laberge1/ZED-F9P_FeatherWing_USB/Eagle/PCB/ZED-F9P GNSS FeatherWing/ZED-F9P GNSS FeatherWing.kicad_pcb

## KiCad design Eagle/PCB/ZED-F9P GNSS FeatherWing/ZED-F9P GNSS FeatherWing.kicad_pcb (2026-06-07)

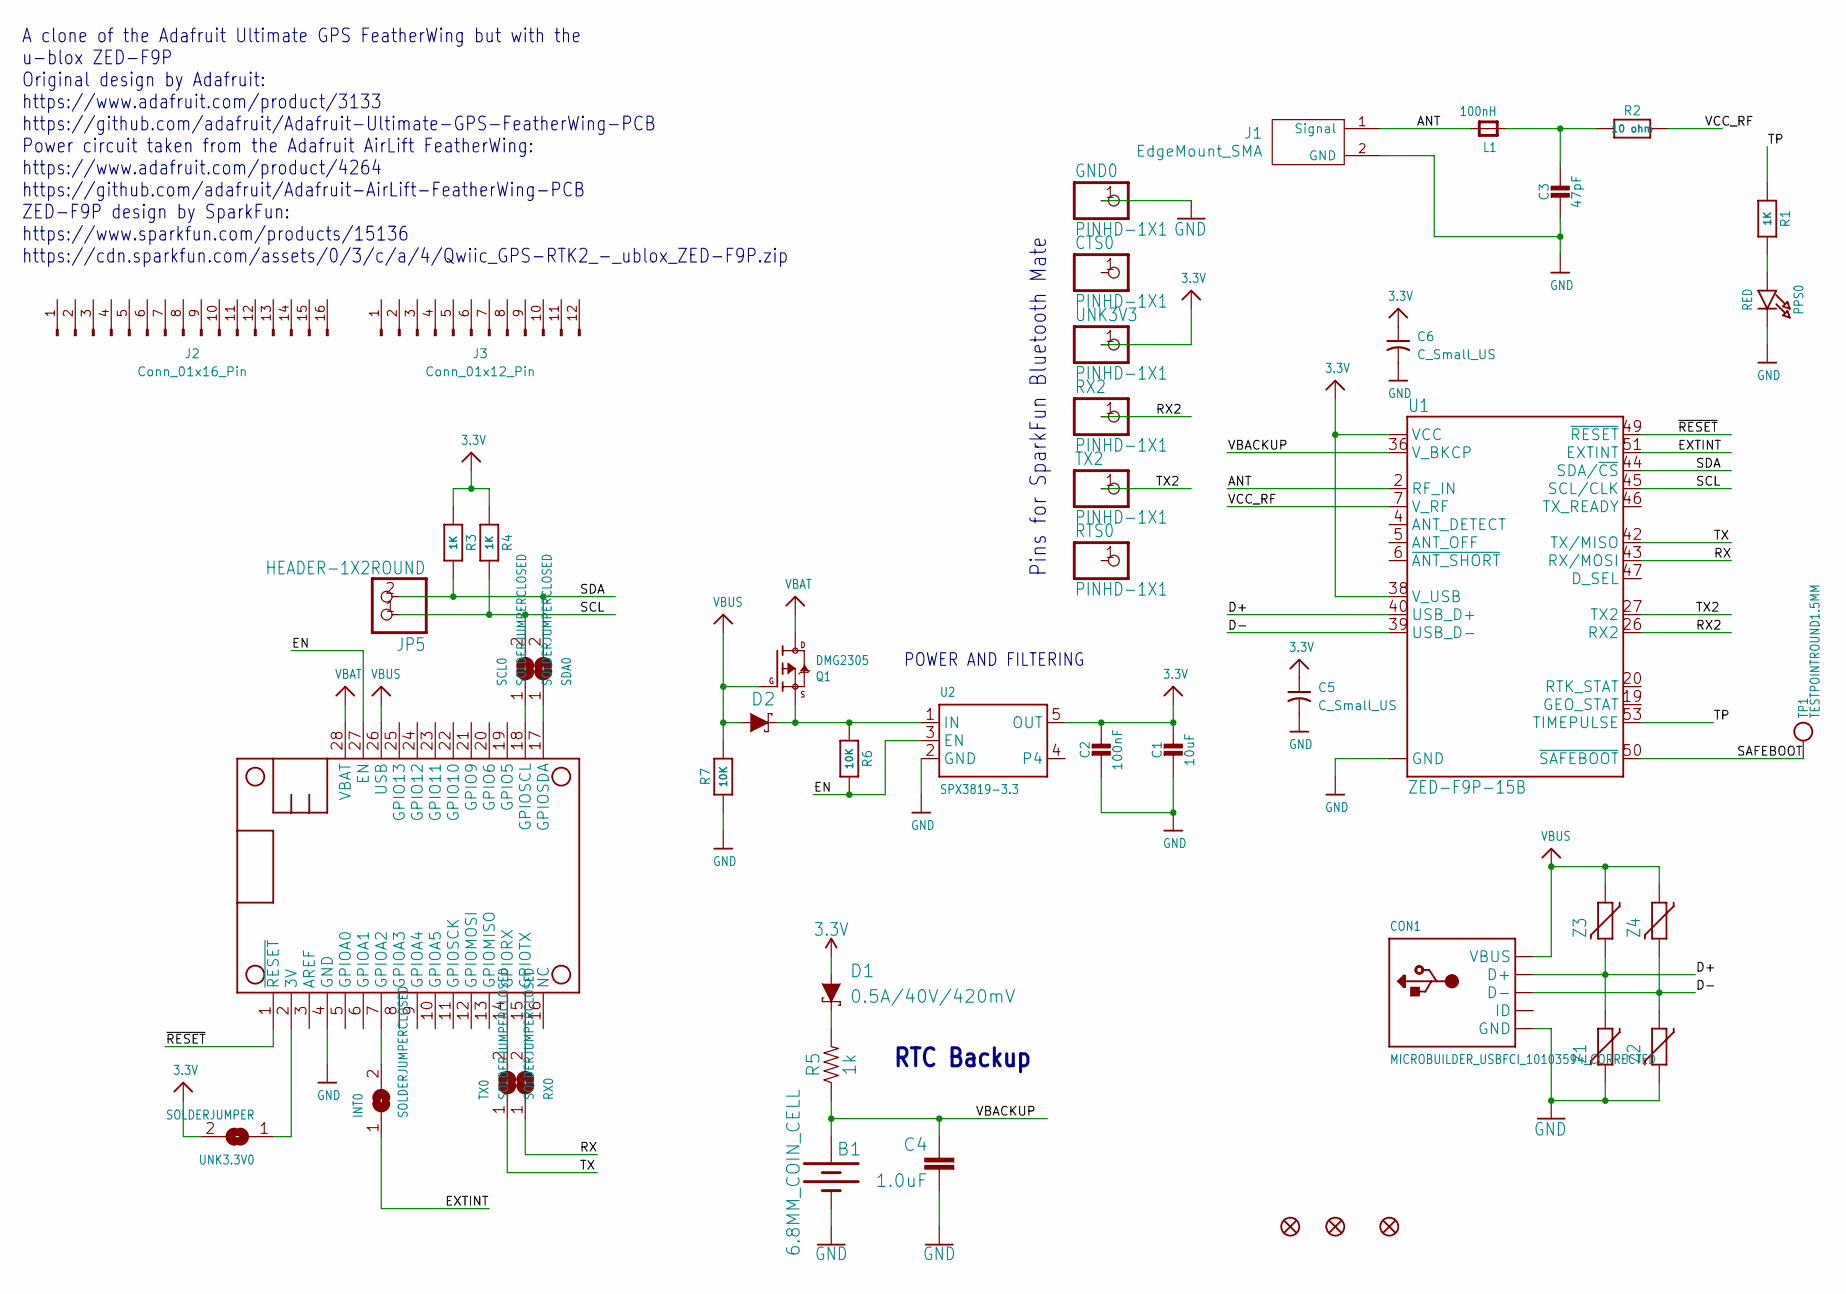
[picture p1: schematic ZED-F9P GNSS FeatherWing.kicad_sch]

Parts:
B1: 6.8MM_COIN_CELL; BATTCON-6.8MM; Digikey PN 728-1057-ND
C1: 10uF; 0805-NO; Voltage 6.3V; Digikey PN 1276-1298-1-ND
C2: 100nF; 0805-NO; Voltage 25V; Digikey PN 1276-2442-1-ND
C3: 47pF; C_0402_1005Metric; Digikey PN 490-14446-1-ND
C4: 1.0uF; 0603; Voltage 10V; Digikey PN 1276-1945-1-ND
C5, C6: C_Small_US; C_0402_1005Metric; Digikey PN 1276-1043-1-ND
CON1: MICROBUILDER_USBFCI_10103594_CORRECTED; MICROBUILDER_FCI_10103594_CORRECTED; Digikey PN 609-4050-1-ND
CTS0: PINHD-1X1; 1X01
D1, D2: 0.5A/40V/420mV; SOD-323; Digikey PN 1801-BAT201M3RRGCT-ND
FID1, FID2, FID3: FIDUCIAL""; Fiducial_0.5mm_Mask1mm
GND0: PINHD-1X1; 1X01
INT0: SOLDERJUMPERCLOSED; SolderJumper-2_P1.3mm_Bridged_RoundedPad1.0x1.5mm
J1: EdgeMount_SMA; SMA_Molex_0732512120; Digikey PN WM5536-ND
J2: Conn_01x16_Pin; Digikey PN 2223-SSK01-MPH-254-A16-ND
J3: Conn_01x12_Pin; Digikey PN 2223-SSK01-MPH-254-A12-ND
JP5: HEADER-1X2ROUND; 1X02_ROUND
L1: 100nH; L_0603_1608Metric; Digikey PN 490-15766-1-ND
MS1: MICROBUILDER_FEATHERWINGMICROBUILDER_FEATHERWING_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; MICROBUILDER_FEATHERWING_HOLES
PPS0: RED; CHIPLED_0805_NOOUTLINE; Digikey PN 732-4984-1-ND
Q1: DMG2305; SOT23-R; Digikey PN FDN340PCT-ND
R1, R3, R4: 1K; 0603-NO; Digikey PN 13-RT0603FRE131KLCT-ND
R2: 10 ohm; R_0402_1005Metric; Digikey PN CR0402-JW-100GLFCT-ND
R5: 1k; 0603; Digikey PN 13-RT0603FRE131KLCT-ND
R6, R7: 10K; 0603-NO; Digikey PN RNCP0603FTD10K0CT-ND
RTS0: PINHD-1X1; 1X01
RX0: SOLDERJUMPERCLOSED; SolderJumper-2_P1.3mm_Bridged_RoundedPad1.0x1.5mm
RX2: PINHD-1X1; 1X01
SCL0: SOLDERJUMPERCLOSED; SolderJumper-2_P1.3mm_Bridged_RoundedPad1.0x1.5mm
SDA0: SOLDERJUMPERCLOSED; SolderJumper-2_P1.3mm_Bridged_RoundedPad1.0x1.5mm
TP1: TESTPOINTROUND1.5MM; TESTPOINT_ROUND_1.5MM
TX0: SOLDERJUMPERCLOSED; SolderJumper-2_P1.3mm_Bridged_RoundedPad1.0x1.5mm
TX2: PINHD-1X1; 1X01
U1: ZED-F9P-15B; ZED-F9P_ZED-F9P; Digikey PN 672-ZED-F9P-15BCT-ND
U2: SPX3819-3.3; SOT23-5; Digikey PN 1016-1873-1-ND
UNK3.3V0: SOLDERJUMPER; SolderJumper-2_P1.3mm_Open_RoundedPad1.0x1.5mm
UNK3V3: PINHD-1X1; 1X01
Z1, Z2, Z3, Z4: CG0603MLC-05E; CT_CN0603; Digikey PN CG0603MLC-05ECT-ND

Connections:
3.3V: C1.1, C2.1, C5.1, C6.1, D1.A, R3.1, R4.1, U1.33 (VCC), U1.34 (VCC), U1.38 (V_USB), U2.5 (OUT), UNK3.3V0.2, UNK3V3.1 (1_1)
/ANT: J1.1 (Signal), L1.2, U1.2 (RF_IN)
/D+: CON1.D+, U1.40 (USB_D+), Z1.1, Z3.2
/D-: CON1.D-, U1.39 (USB_D-), Z2.1, Z4.2
/EN: MS1.27 (EN), R6.2, U2.3 (EN)
/EXTINT: INT0.1, U1.51 (EXTINT)
/RX: RX0.1, U1.43 (RX/MOSI)
/RX2: RX2.1 (1_1), U1.26 (RX2)
/SAFEBOOT: TP1.P$1 (P$1_P$1), U1.50 (~SAFEBOOT)
/SCL: JP5.1, R4.2, SCL0.2, U1.45 (SCL/CLK)
/SDA: JP5.2, R3.2, SDA0.2, U1.44 (SDA/~CS)
/TP: R1.1, U1.53 (TIMEPULSE)
/TX: TX0.1, U1.42 (TX/MISO)
/TX2: TX2.1 (1_1), U1.27 (TX2)
/VBACKUP: B1.+, C4.1, R5.1, U1.36 (V_BKCP)
/VCC_RF: R2.2, U1.7 (V_RF)
/~RESET: MS1.1 (~RESET), U1.49 (~RESET)
GND: B1.-, C1.2, C2.2, C3.2, C4.2, C5.2, C6.2, CON1.BASE@1 (GND), CON1.BASE@2 (GND), CON1.GND, CON1.SPRT@1 (GND), CON1.SPRT@2 (GND), CON1.SPRT@3 (GND), CON1.SPRT@4 (GND), GND0.1 (1_1), J1.2 (GND), MS1.4 (GND), PPS0.C, R7.1, U1.1 (GND), U1.3 (GND), U1.12 (GND), U1.14 (GND), U1.32 (GND), U1.37 (GND), U1.41 (GND), U1.48 (GND), U1.55 (GND), U1.56 (GND), U1.57 (GND), U1.58 (GND), U1.59 (GND), U1.60 (GND), U1.61 (GND), U1.62 (GND), U1.63 (GND), U1.64 (GND), U1.65 (GND), U1.66 (GND), U1.67 (GND), U1.68 (GND), U1.69 (GND), U1.70 (GND), U1.71 (GND), U1.72 (GND), U1.73 (GND), U1.74 (GND), U1.75 (GND), U1.76 (GND), U1.77 (GND), U1.78 (GND), U1.79 (GND), U1.80 (GND), U1.81 (GND), U1.82 (GND), U1.83 (GND), U1.84 (GND), U1.85 (GND), U1.86 (GND), U1.87 (GND), U1.88 (GND), U1.89 (GND), U1.90 (GND), U1.91 (GND), U1.92 (GND), U1.93 (GND), U1.94 (GND), U1.95 (GND), U1.96 (GND), U1.97 (GND), U1.98 (GND), U1.99 (GND), U1.100 (GND), U1.101 (GND), U1.102 (GND), U2.2 (GND), Z1.2, Z2.2
unnamed: D1.C, R5.2
unnamed: C3.1, L1.1, R2.1
unnamed: MS1.2 (3V), UNK3.3V0.1
unnamed: INT0.2, MS1.7 (GPIOA2)
unnamed: MS1.14 (GPIORX), TX0.2
unnamed: MS1.18 (GPIOSCL), SCL0.1
unnamed: MS1.17 (GPIOSDA), SDA0.1
unnamed: MS1.15 (GPIOTX), RX0.2
unnamed: PPS0.A, R1.2
unnamed: D2.C, Q1.2 (S), R6.1, U2.1 (IN)
VBAT: MS1.28 (VBAT), Q1.3 (D)
VBUS: CON1.VBUS, D2.A, MS1.26 (USB), Q1.1 (G), R7.2, Z3.1, Z4.1

Notes on the sheet:
POWER AND FILTERING
A clone of the Adafruit Ultimate GPS FeatherWing but with the u-blox ZED-F9P Original design by Adafruit: https://www.adafruit.com/product/3133 https://github.com/adafruit/Adafruit-Ultimate-GPS-FeatherWing-PCB Power circuit taken from the Adafruit AirLift FeatherWing: https://www.adafruit.com/produ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
RTC Backup
Pins for SparkFun Bluetooth Mate

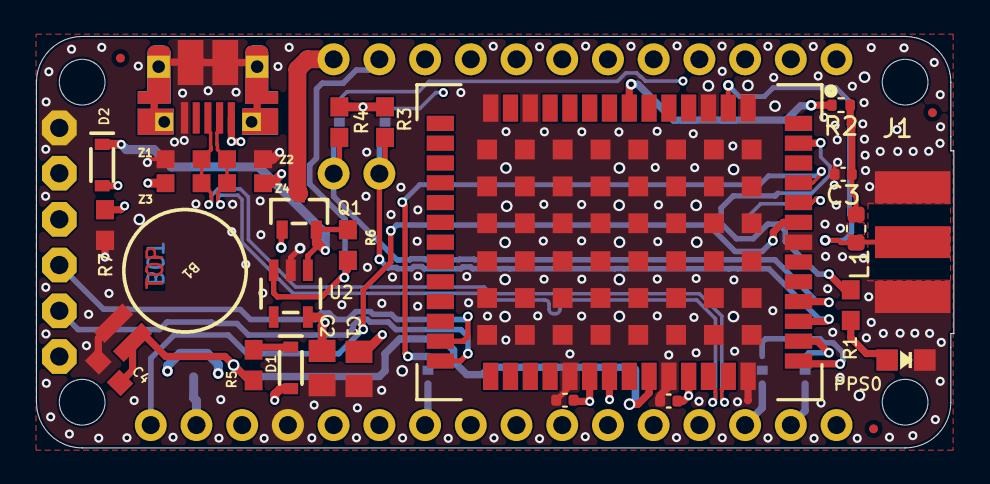
[picture p2: board ZED-F9P GNSS FeatherWing.kicad_pcb from above]

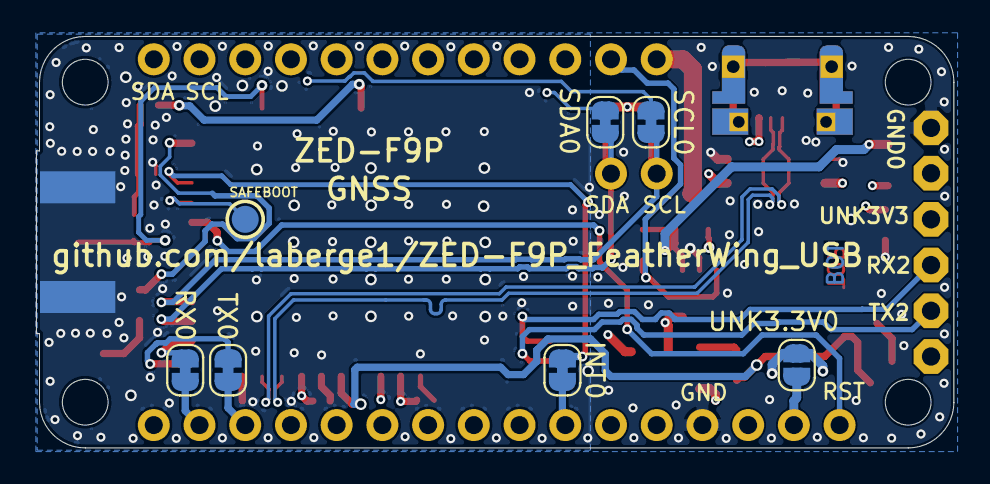
[picture p3: board ZED-F9P GNSS FeatherWing.kicad_pcb from below]

Board: 4 copper layers, 51.0 x 22.9 mm, 45 parts (13 on the bottom side), 30 nets.
