laberge1/ZED-F9P_FeatherWing_USB/(commit log)

2026-03-21 Translated to Kicad
    [ZED-F9P GNSS FeatherWing.kicad_pcb, ZED-F9P GNSS FeatherWing.kicad_sch]
2026-03-23 Minor updates
    [ZED-F9P GNSS FeatherWing.kicad_pcb]
2026-05-29 Update to Kicad 10 and added SMA
    [ZED-F9P GNSS FeatherWing.kicad_pcb, ZED-F9P GNSS FeatherWing.kicad_sch]
2026-06-07 V2 Release
    Released to fab.
    [ZED-F9P GNSS FeatherWing-B_Cu.gbr, ZED-F9P GNSS FeatherWing-B_Mask.gbr, ZED-F9P GNSS FeatherWing-B_Paste.gbr, ZED-F9P GNSS FeatherWing-B_Silkscreen.gbr, ZED-F9P GNSS FeatherWing-Edge_Cuts.gbr, ZED-F9P GNSS FeatherWing-F_Cu.gbr, ZED-F9P GNSS FeatherWing-F_Mask.gbr, ZED-F9P GNSS FeatherWing-F_Paste.gbr]
